Sandgrube/StepperMotorTestBench/Photos/PXL_20261024_214037839_cleaned.jpg

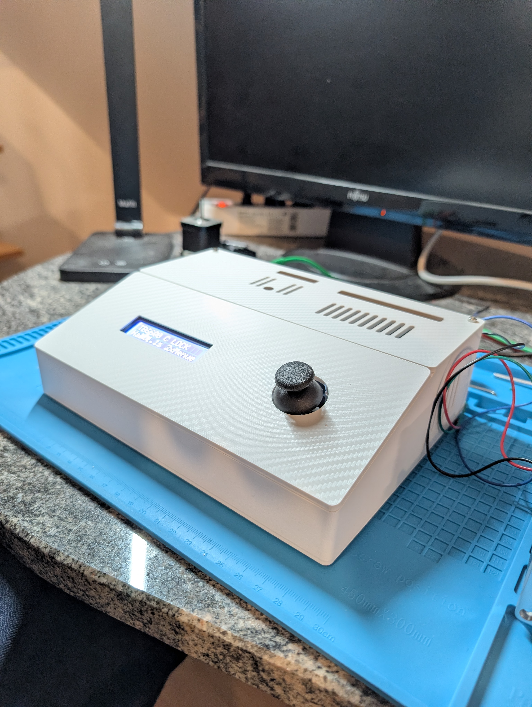
Photos/PXL_20261024_214037839_cleaned.jpg
