Sandgrube/StepperMotorTestBench/Photos/PXL_20261024_214016958_cleaned.jpg

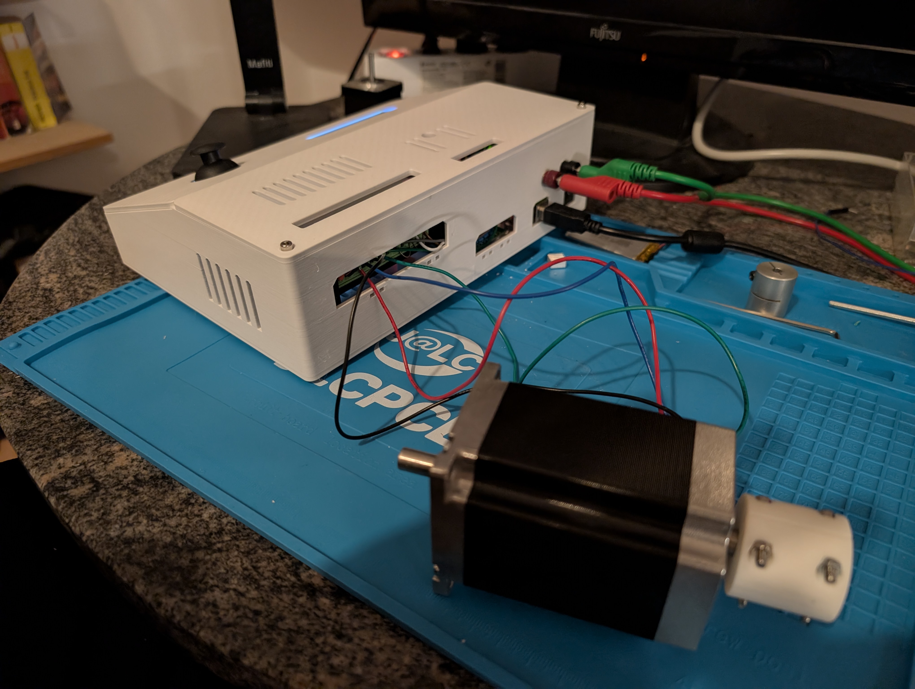
Photos/PXL_20261024_214016958_cleaned.jpg
