Sandgrube/StepperMotorTestBench/DOCUMENTATION/architecture.md

# Aufbau und Auswahl

Der Entwurf ist ein vollständig modellierter, passiv belüfteter Laboraufbau für die fünf vorgegebenen Module. Die Front trägt ausschließlich das vorhandene LCD und den Joystick. Alle Netzteile bleiben außerhalb. Drei Gehäuseteile: Bodenschale, fest verschraubte geneigte Front, separat abnehmbarer hinterer Deckel. Auf der Front sind keine Schraubenköpfe sichtbar; zwei Senkschrauben halten den Wartungsdeckel.

Verglichen wurden drei Verpackungsprinzipien. Nur Variante B wurde detailliert konstruiert und geometrisch geprüft. Die anderen Maße sind grobe Planungsabschätzungen, keine exportierten Alternativmodelle.

| Variante | Planungsmaß / Quader | Bewertung |
| --- | --- | --- |
| A: Treiber unter den Bedienelementen übereinander | ca. 180 × 176 × 85 mm / 2,69 l | Kleine Stellfläche; thermische Kopplung zum LCD; obere Module müssten zur Wartung heraus. |
| B: Drei Funktionszonen nebeneinander; gewählt | 230 × 176 × 64.24 mm / 2.60 l | Gemeinsamer offener Wartungsraum; eigene Wärmewege; kurze direkte Heckanschlüsse. |
| C: Alle Module hintereinander | ca. 150 × 230 × 72 mm / 2,48 l | Schmale, tiefe Stellfläche; mehr Leitungslänge und schlechtere seitliche Werkzeugzugänge. |

Die etwas größere Breite der gewählten Variante schafft reale Breite für Uno, 40-mm-Lochrasterplatine, TB6600 und deren Halter. Die vordere Zone enthält die Rückseiten von LCD und Joystick, vier Frontstützen sowie den Kabelbogen. Sie ist kein Platz für zusätzliche Elektronik.

Der TB6600 wird mit zwei verschiebbaren Bügeln und weichen Auflagepolstern gehalten. Originale Gehäuseschrauben und unbestätigte Modul-Bohrbilder werden nicht benutzt. Die Lochrasterplatine sitzt in Kantenhaltern und benötigt keine gebohrten Befestigungslöcher. Die Joystick-Montage verwendet vier 2-mm-Distanzringe; dünnere Ringe können einen kürzeren Knopf näher an die Außenseite bringen. Eine geänderte Bestückung ist erneut am Probestück zu prüfen.
