Sandgrube/StepperMotorTestBench/Photos/PXL_20261024_143449900_cleaned.jpg

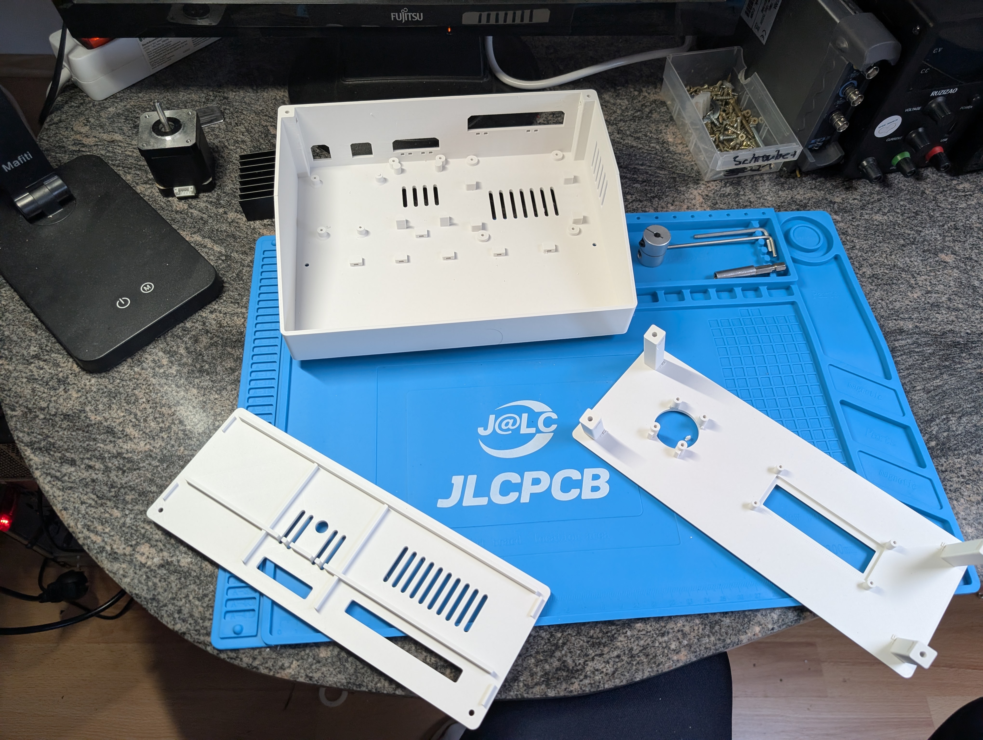
Photos/PXL_20261024_143449900_cleaned.jpg
