Sandgrube/StepperMotorTestBench/Photos/PXL_20261024_155425941 (1)_cleaned.jpg

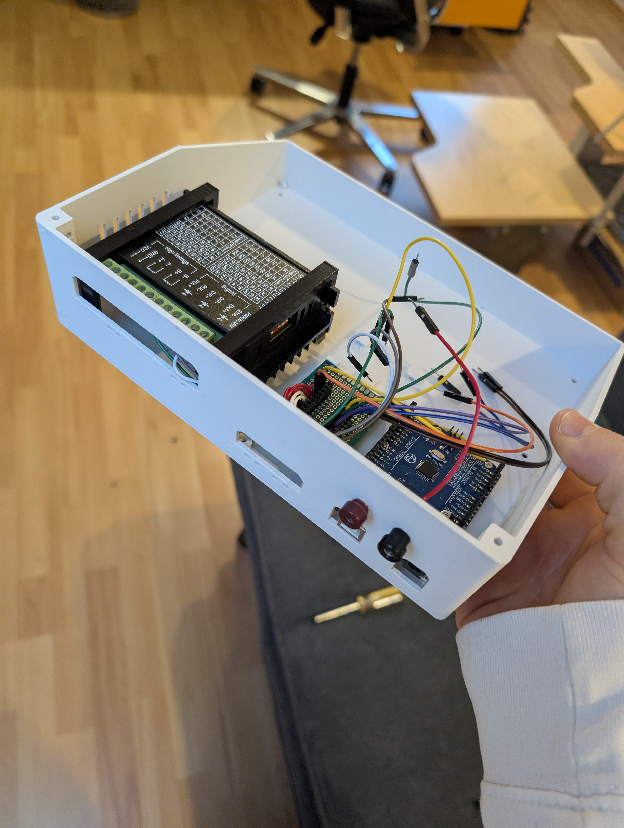
Photos/PXL_20261024_155425941 (1)_cleaned.jpg
