Sandgrube/StepperMotorTestBench/Photos/PXL_20261024_214004681_cleaned.jpg

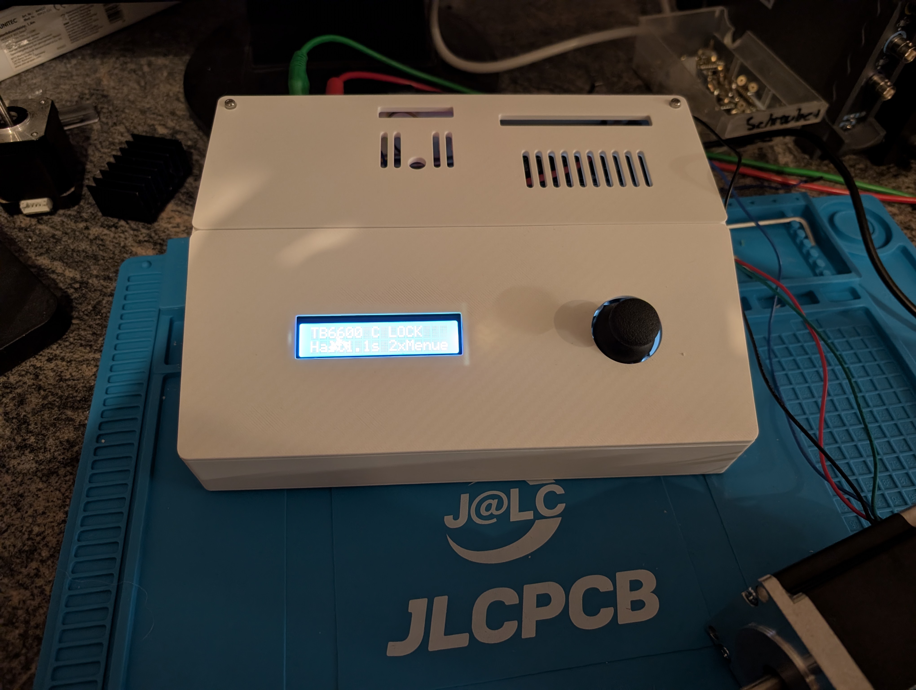
Photos/PXL_20261024_214004681_cleaned.jpg
