Sandgrube/StepperMotorTestBench/Photos/PXL_20261024_214041481_cleaned.jpg

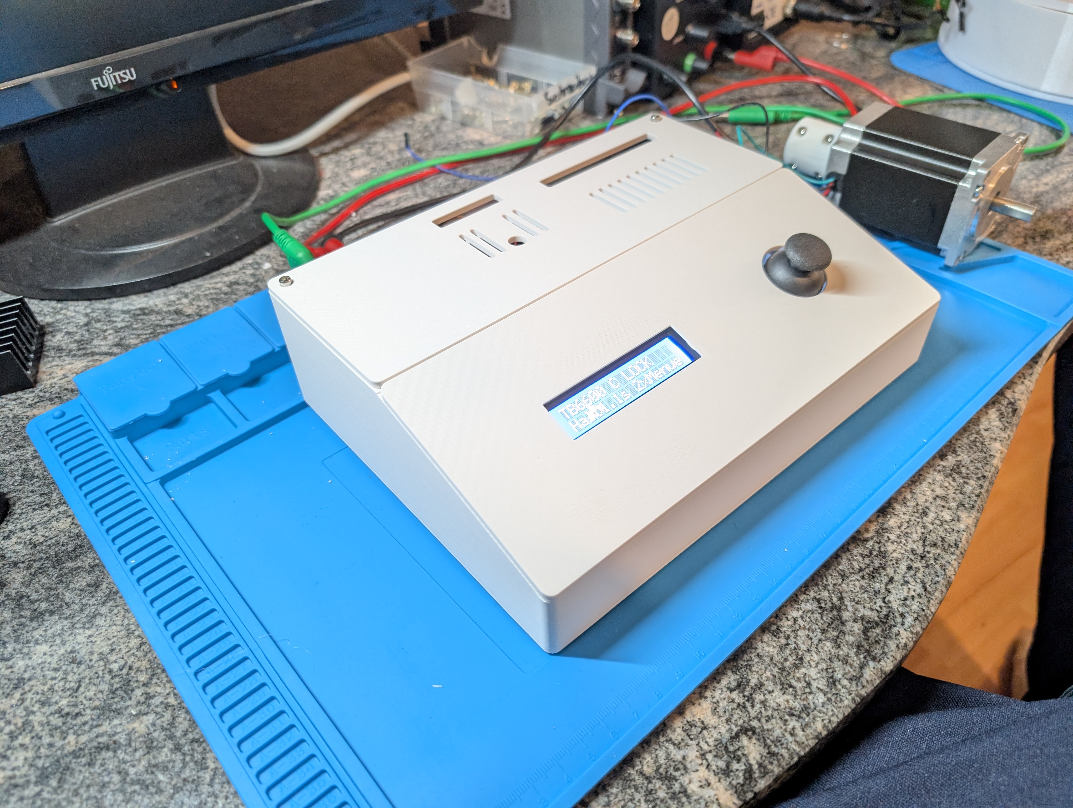
Photos/PXL_20261024_214041481_cleaned.jpg
