Sandgrube/StepperMotorTestBench/Photos/PXL_20261024_214044167_cleaned.jpg

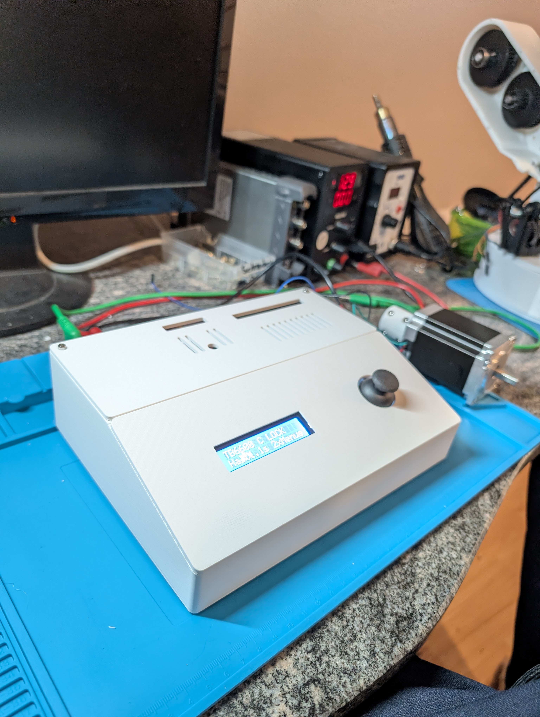
Photos/PXL_20261024_214044167_cleaned.jpg
