Sandgrube/StepperMotorTestBench/Photos/PXL_20261024_214047961_cleaned.jpg

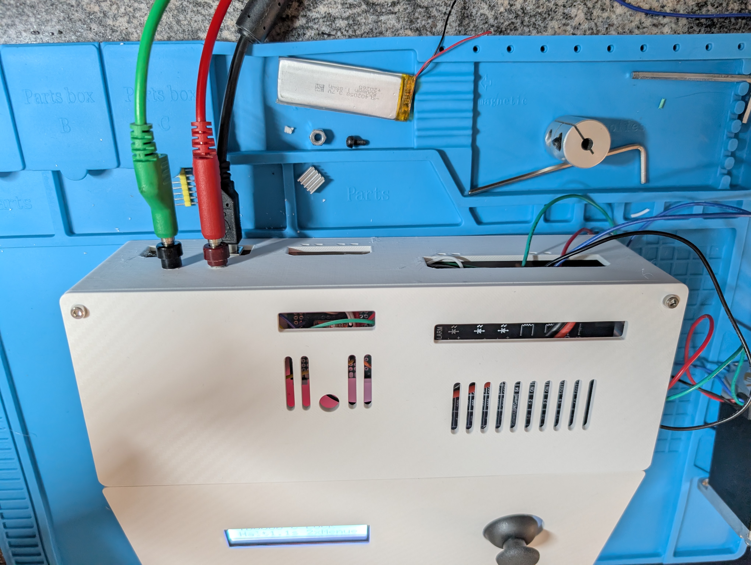
Photos/PXL_20261024_214047961_cleaned.jpg
