Sandgrube/StepperMotorTestBench/Photos/PXL_20261024_214056082_cleaned.jpg

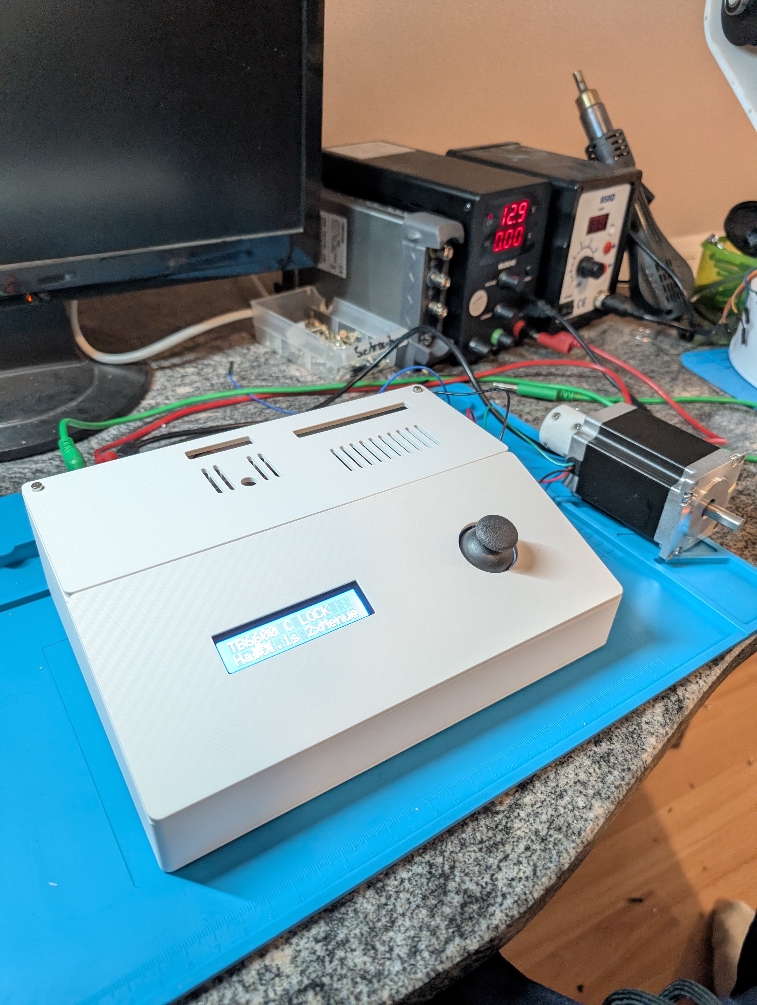
Photos/PXL_20261024_214056082_cleaned.jpg
