Sandgrube/StepperMotorTestBench/PREVIEWS/exploded.png

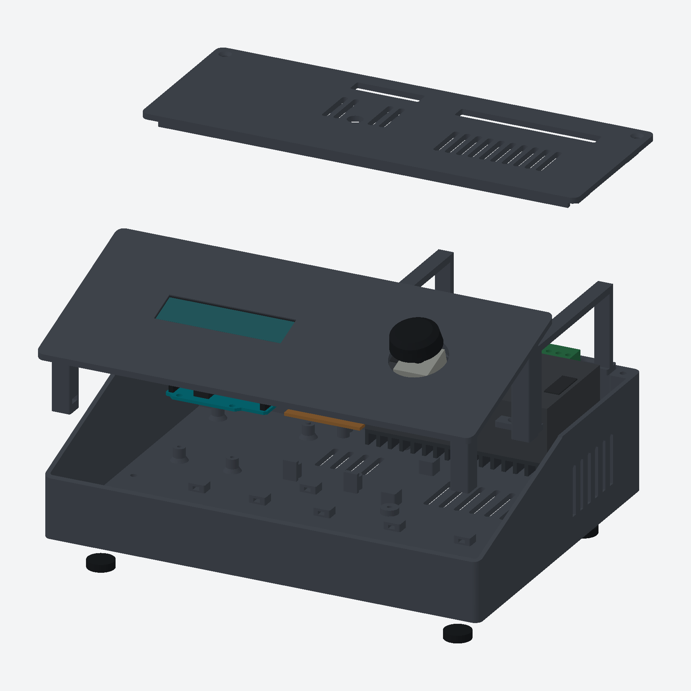
PREVIEWS/exploded.png
