Sandgrube/StepperMotorTestBench/PREVIEWS/front_ortho.png

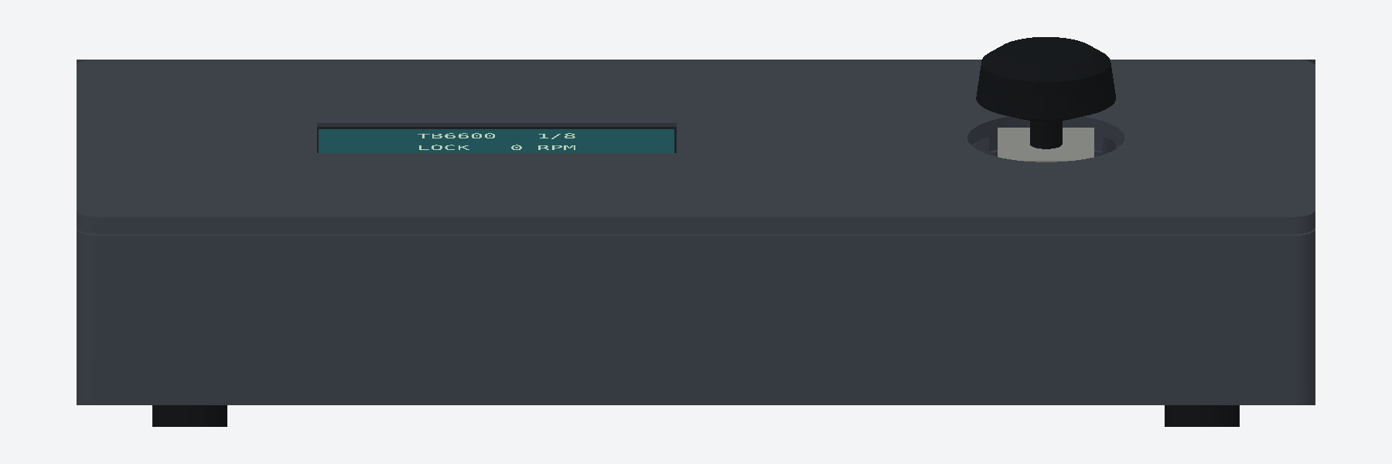
PREVIEWS/front_ortho.png
