Sandgrube/StepperMotorTestBench/PREVIEWS/front_rear_views.png

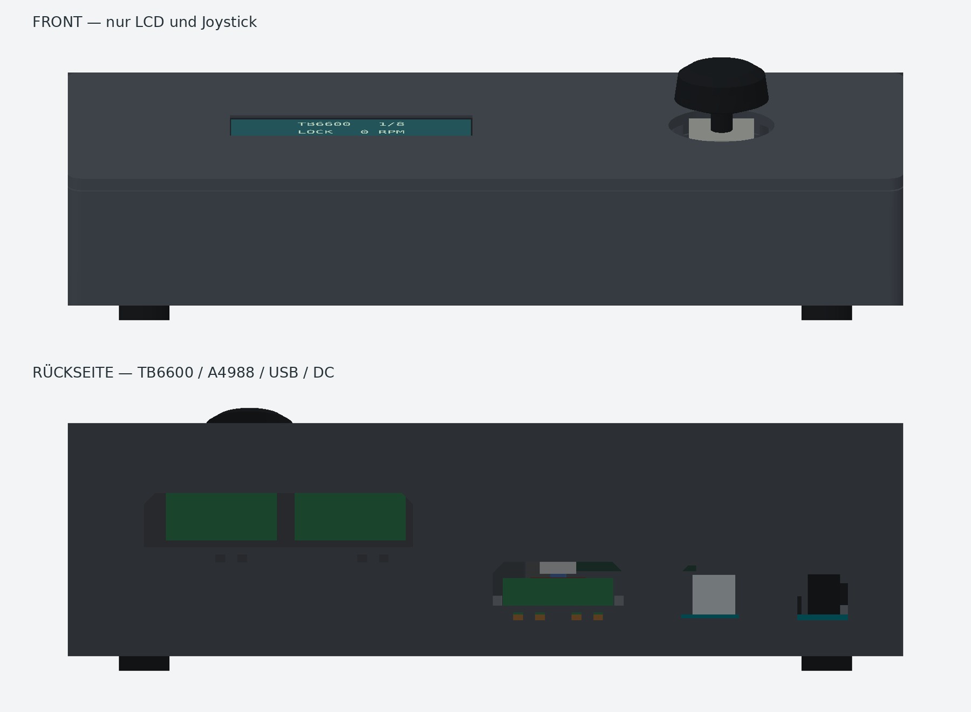
PREVIEWS/front_rear_views.png
