Sandgrube/StepperMotorTestBench/PREVIEWS/internal_layout.png

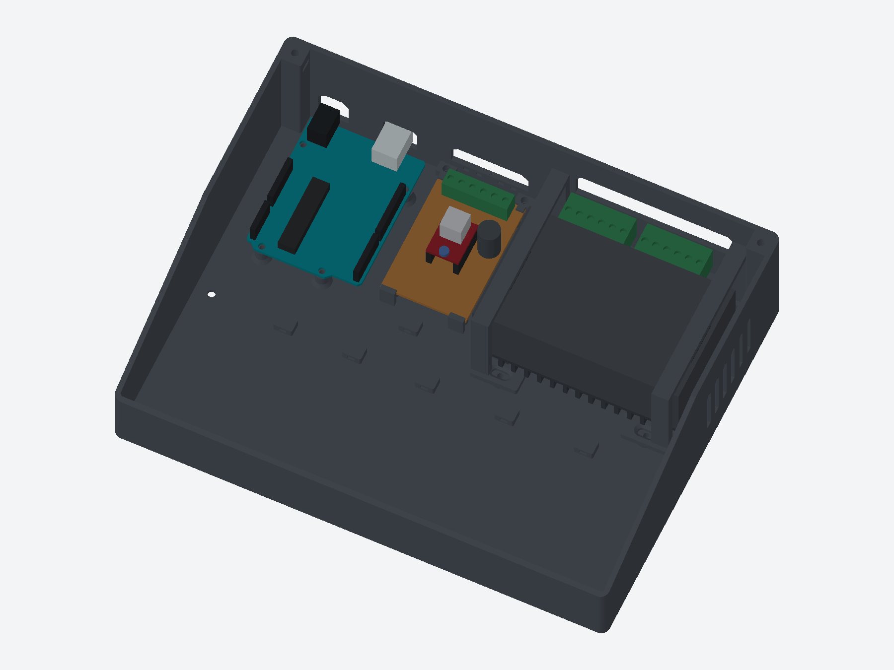
PREVIEWS/internal_layout.png
