Sandgrube/StepperMotorTestBench/PREVIEWS/rear.png

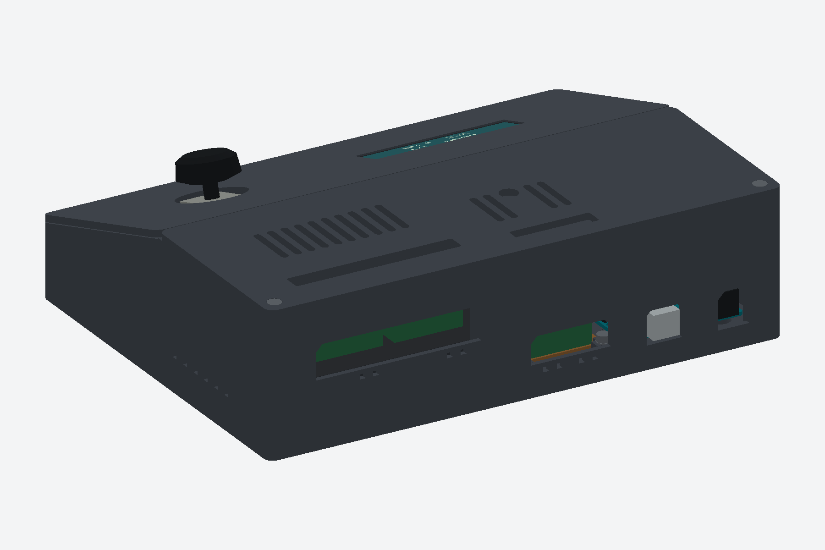
PREVIEWS/rear.png
