Sandgrube/StepperMotorTestBench/PREVIEWS/rear_ortho.png

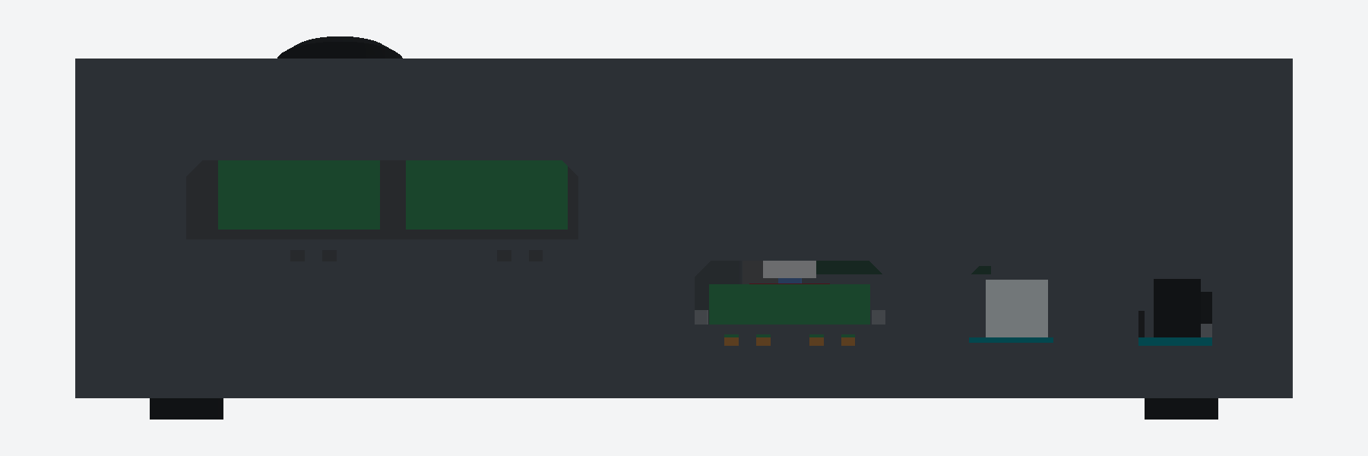
PREVIEWS/rear_ortho.png
