Sandgrube/StepperMotorTestBench/CAD/component_models/README.md

# Referenzkörper

Die STEP-Dateien enthalten selbst erzeugte vereinfachte B-reps in Einbaulage. Sie sind keine OEM-zertifizierten Produktmodelle. Lochkoordinaten und gesicherte Daten: siehe DOCUMENTATION/dimensions.md und sources.md. Die Datei uno_official_interface_extract.json enthält die Herkunft der Uno-XY-Schnittstellen. Keine fremden Polygonmodelle sind nötig, um die Baugruppe zu regenerieren.
