Sandgrube/StepperMotorTestBench/CAD/printed_parts_assembly.step

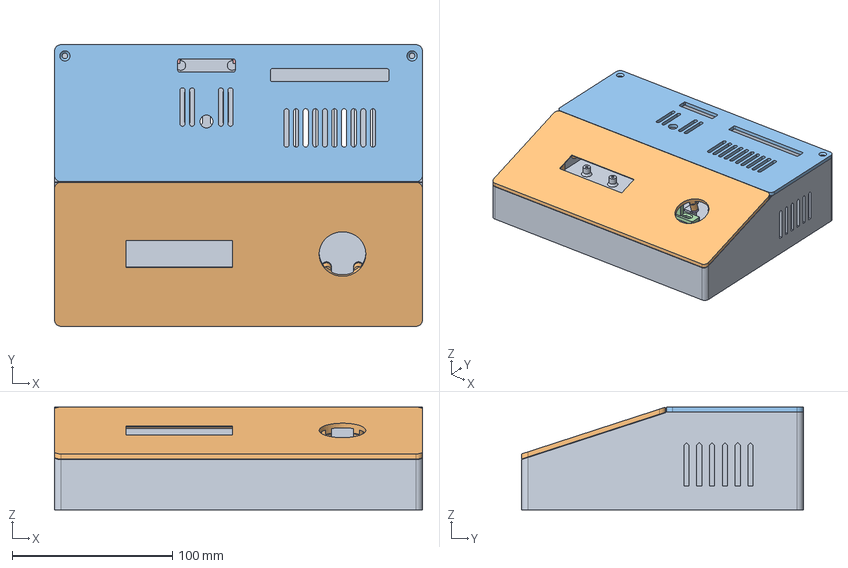
[picture p16: CAD file, 2026-10-23]
CAD/printed_parts_assembly.step
230.0 x 176.0 x 64.2 mm
