Sandgrube/StepperMotorTestBench/PRINT/assembly.3mf

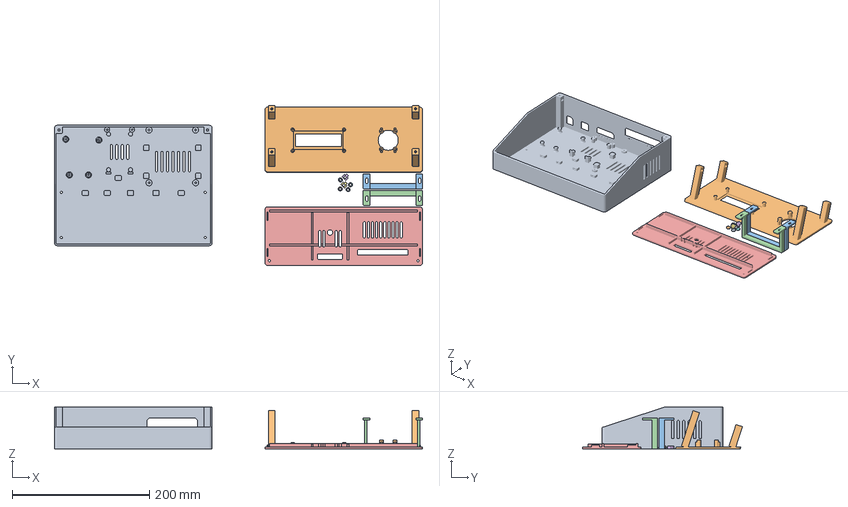
[picture p17: CAD file, 2026-10-24]
PRINT/assembly.3mf
537.2 x 233.5 x 61.2 mm
main_chassis.stl
front_panel.stl
tb_clamp_left.stl
tb_clamp_right.stl
top_cover.stl
a4988_edge_clip_1.stl
a4988_edge_clip_2.stl
joystick_spacer_1.stl
joystick_spacer_2.stl
joystick_spacer_3.stl
joystick_spacer_4.stl
