Sandgrube/StepperMotorTestBench/CAD/main_assembly.step

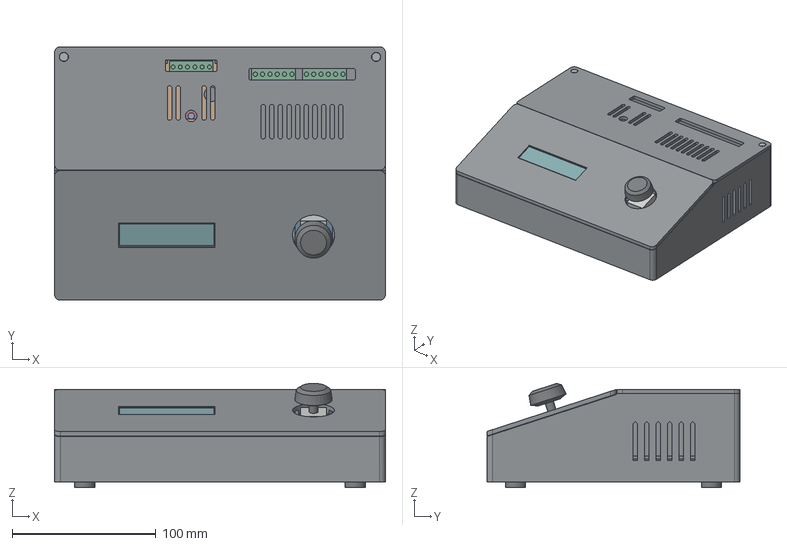
[picture p18: CAD file, 2026-10-23]
CAD/main_assembly.step
230.0 x 176.0 x 72.4 mm
main_chassis
front_panel
top_cover
tb_clamp_left
tb_clamp_right
a4988_edge_clip_1
a4988_edge_clip_2
joystick_spacer_1
joystick_spacer_2
joystick_spacer_3
joystick_spacer_4
UNO_PCB
UNO_USB
UNO_DC
UNO_header_0
UNO_header_1
UNO_header_2
UNO_header_3
UNO_DIP_envelope
LCD_PCB
LCD_bezel
LCD_glass
LCD_I2C_backpack_envelope
LCD_I2C_plug_keepout
JOYSTICK_PCB
JOYSTICK_gimbal_envelope
JOYSTICK_knob_and_stem
JOYSTICK_5pin_plug_keepout
TB6600_heatsink_reference
TB6600_housing_envelope
TB6600_terminal_0
TB6600_terminal_1
TB6600_compressed_foam_pad_0
TB6600_compressed_foam_pad_1
A4988_perfboard_40x60
A4988_socket_88.65
A4988_socket_101.35
A4988_driver_PCB
A4988_heatsink_envelope
A4988_pot_reference
A4988_VMOT_capacitor_envelope
A4988_6way_terminal_reference
adhesive_foot_0
adhesive_foot_1
adhesive_foot_2
adhesive_foot_3
M3x12_panel_0_head
M3x12_panel_0_shaft
M3_nut_panel_0
M3x12_panel_1_head
M3x12_panel_1_shaft
M3_nut_panel_1
M3x12_panel_2_head
M3x12_panel_2_shaft
M3_nut_panel_2
M3x12_panel_3_head
M3x12_panel_3_shaft
M3_nut_panel_3
M3x12_lid_0_head
M3x12_lid_0_shaft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
