Sandgrube/StepperMotorTestBench/PRINT/main_chassis.stl

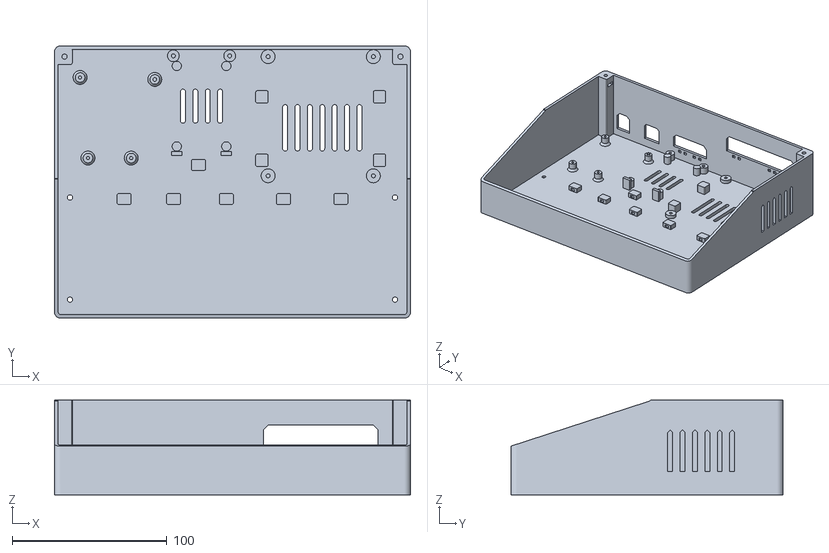
[picture p19: CAD file, 2026-10-23]
PRINT/main_chassis.stl
230.0 x 176.0 x 61.2
