Sandgrube/StepperMotorTestBench/CAD/component_models/uno_reference.step

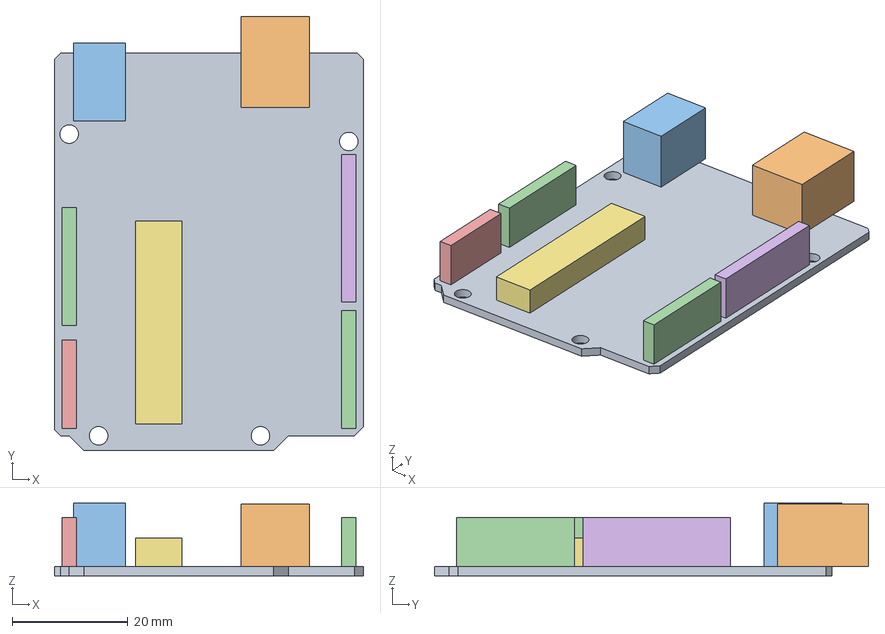
[picture p20: CAD file, 2026-10-23]
CAD/component_models/uno_reference.step
53.3 x 74.9 x 12.6 mm
