Sandgrube/StepperMotorTestBench/CAD/printed_parts/tb_clamp_left.step

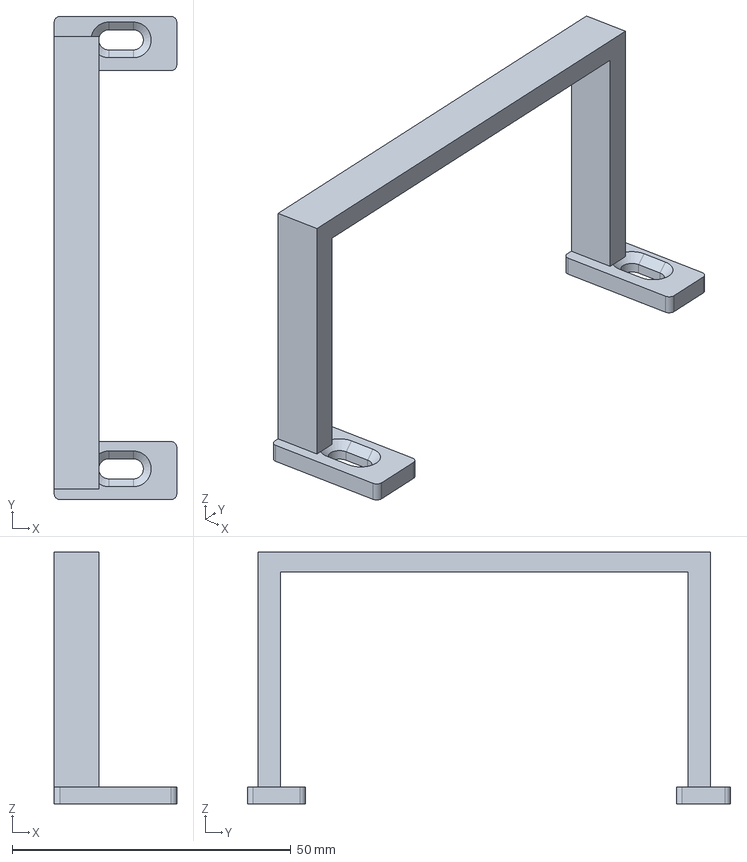
[picture p21: CAD file, 2026-10-23]
CAD/printed_parts/tb_clamp_left.step
22.0 x 86.7 x 45.2 mm
