Sandgrube/StepperMotorTestBench/PRINT/optional_parts/tpu_foot_print_4.stl

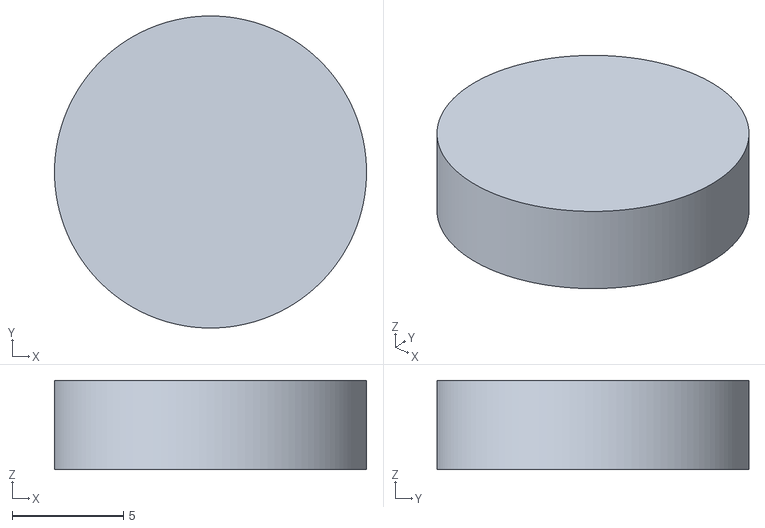
[picture p22: CAD file, 2026-10-23]
PRINT/optional_parts/tpu_foot_print_4.stl
14.0 x 14.0 x 4.00
