Sandgrube/StepperMotorTestBench/PRINT/tolerance_tests/m3_pilot_coupon.stl

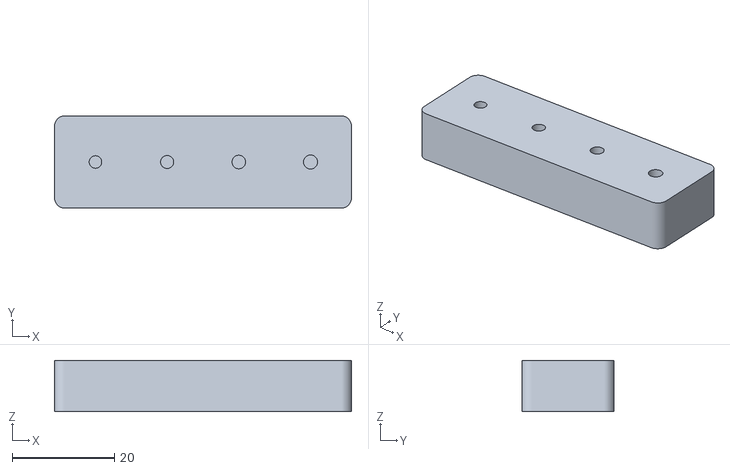
[picture p23: CAD file, 2026-10-23]
PRINT/tolerance_tests/m3_pilot_coupon.stl
58.0 x 18.0 x 10.0
