Sandgrube/StepperMotorTestBench/CAD/component_models/tb6600_reference.step

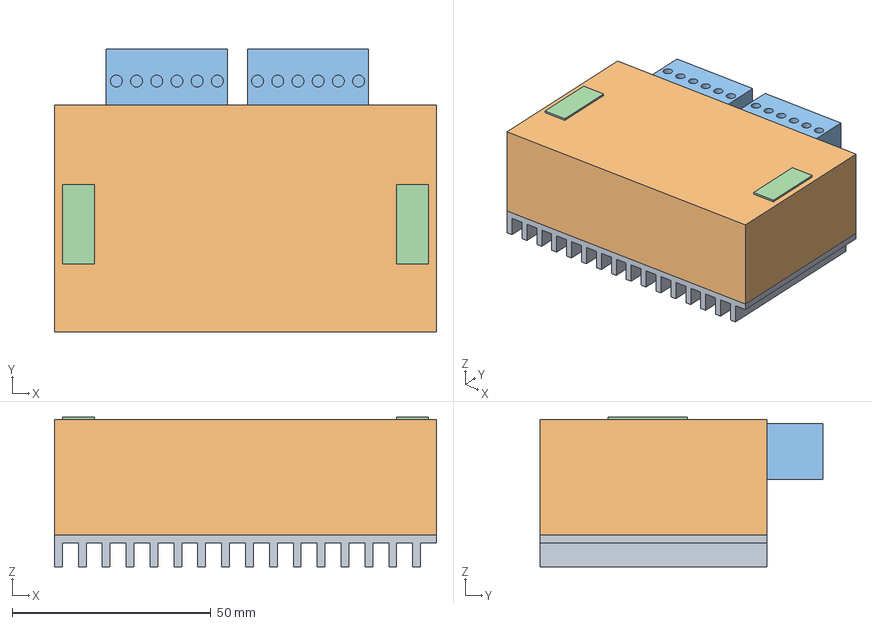
[picture p24: CAD file, 2026-10-23]
CAD/component_models/tb6600_reference.step
96.0 x 71.0 x 37.6 mm
