Sandgrube/StepperMotorTestBench/CAD/printed_parts/joystick_spacer_2.step

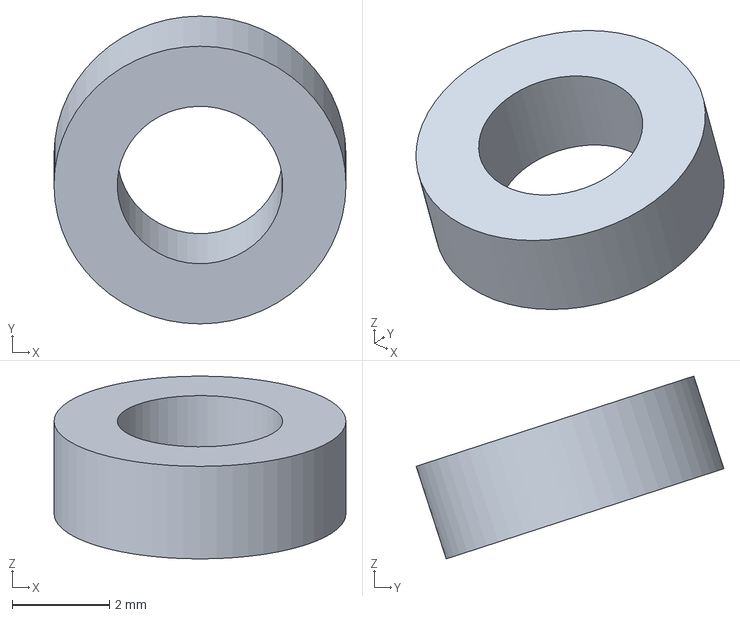
[picture p25: CAD file, 2026-10-23]
CAD/printed_parts/joystick_spacer_2.step
6.00 x 6.32 x 3.76 mm
