Sandgrube/StepperMotorTestBench/PRINT/tolerance_tests/joystick_pattern_coupon.stl

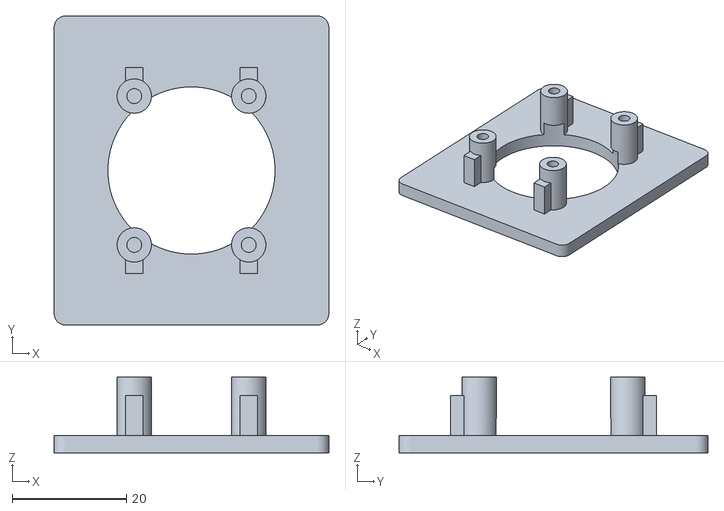
[picture p26: CAD file, 2026-10-23]
PRINT/tolerance_tests/joystick_pattern_coupon.stl
48.0 x 54.0 x 13.2
