Sandgrube/StepperMotorTestBench/CAD/component_models/joystick_reference.step

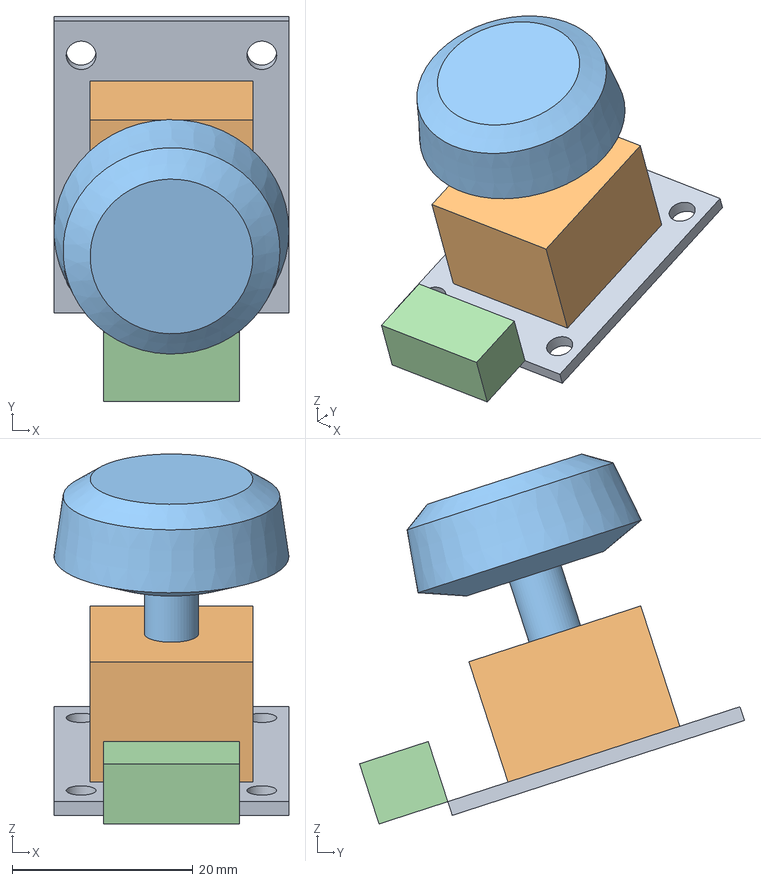
[picture p27: CAD file, 2026-10-23]
CAD/component_models/joystick_reference.step
26.0 x 42.6 x 40.9 mm
