Sandgrube/StepperMotorTestBench/PRINT/joystick_spacer_4.stl

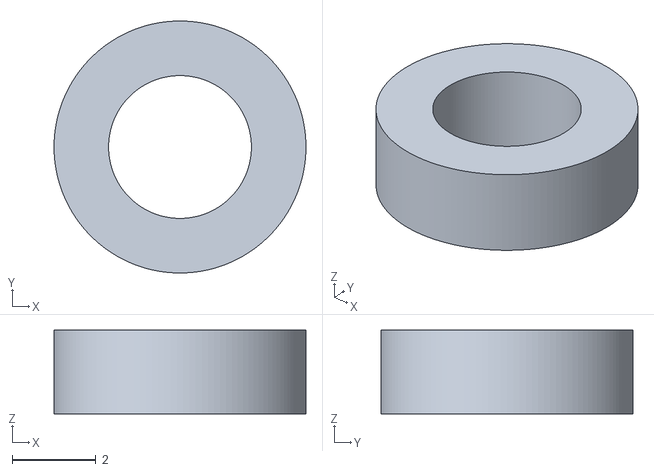
[picture p28: CAD file, 2026-10-23]
PRINT/joystick_spacer_4.stl
6.00 x 6.00 x 2.00
