Sandgrube/StepperMotorTestBench/CAD/component_models/lcd_reference.step

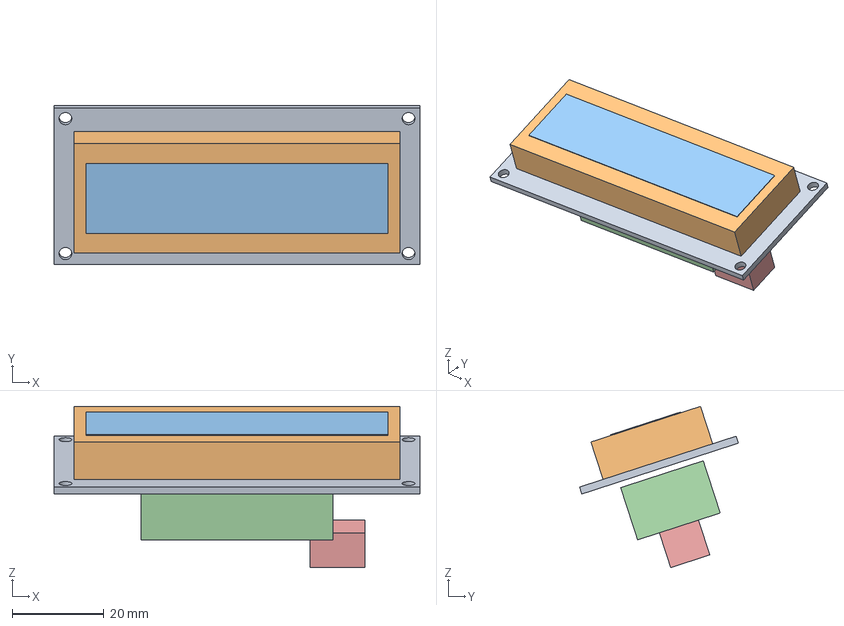
[picture p29: CAD file, 2026-10-23]
CAD/component_models/lcd_reference.step
80.0 x 34.7 x 35.2 mm
