Sandgrube/StepperMotorTestBench/CAD/printed_parts/lcd_fit_coupon.step

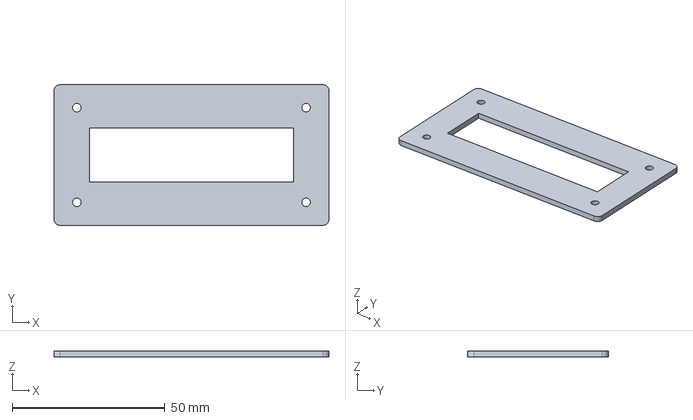
[picture p30: CAD file, 2026-10-23]
CAD/printed_parts/lcd_fit_coupon.step
90.0 x 46.0 x 2.00 mm
