Sandgrube/StepperMotorTestBench/PRINT/a4988_edge_clip_2.stl

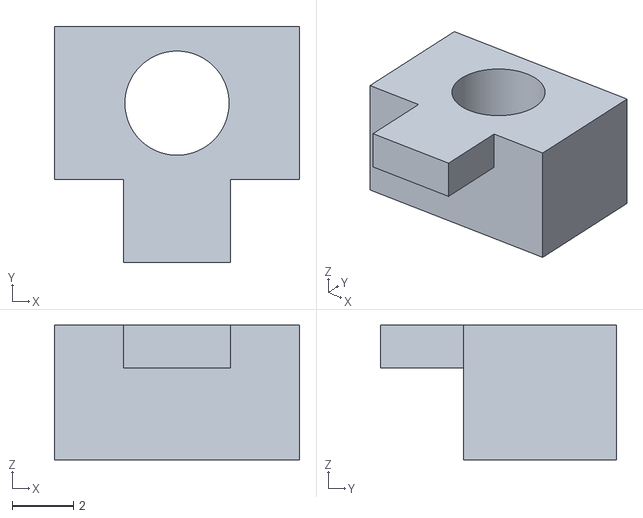
[picture p31: CAD file, 2026-10-23]
PRINT/a4988_edge_clip_2.stl
8.00 x 7.70 x 4.40
