Sandgrube/StepperMotorTestBench/PRINT/tolerance_tests/rear_ports_coupon.stl

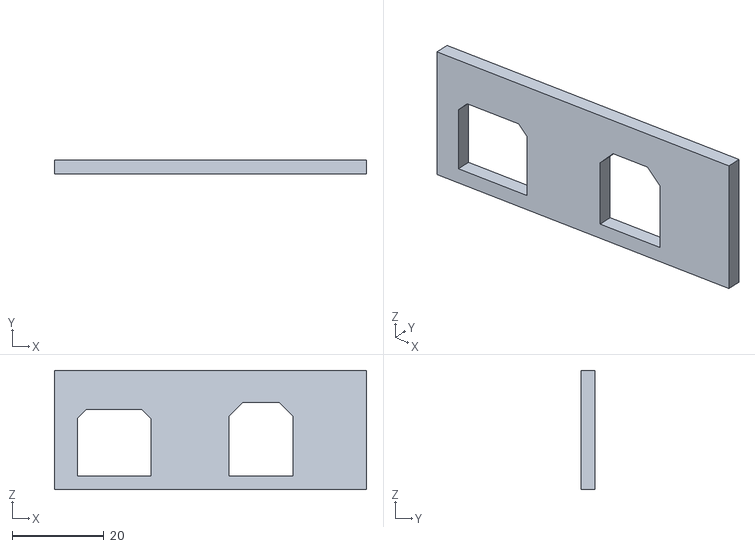
[picture p32: CAD file, 2026-10-23]
PRINT/tolerance_tests/rear_ports_coupon.stl
68.0 x 3.00 x 26.0
