Sandgrube/StepperMotorTestBench/CAD/component_models/a4988_reference.step

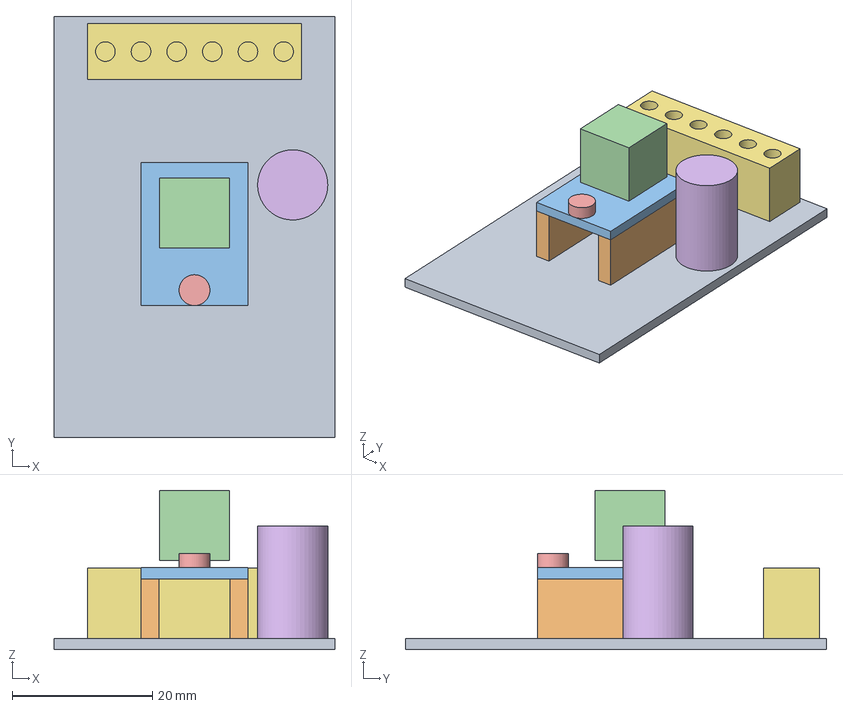
[picture p33: CAD file, 2026-10-23]
CAD/component_models/a4988_reference.step
40.0 x 60.0 x 22.7 mm
