Sandgrube/StepperMotorTestBench/CAD/component_models/feet_reference.step

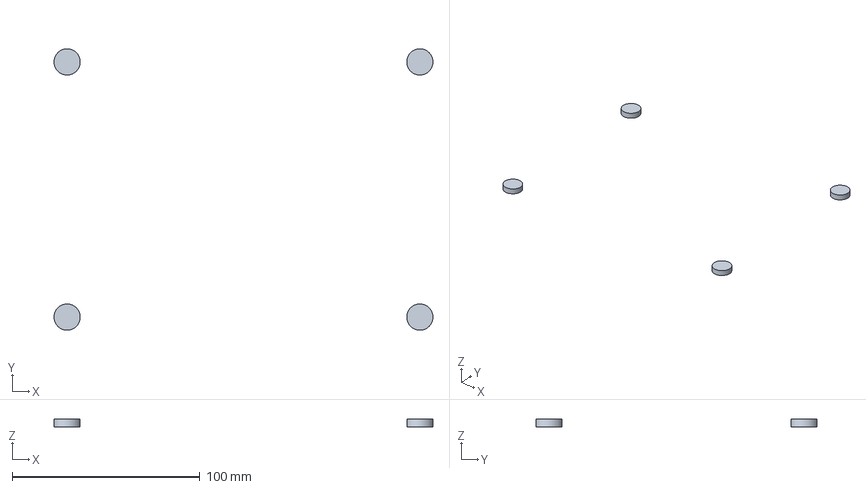
[picture p34: CAD file, 2026-10-23]
CAD/component_models/feet_reference.step
202.0 x 150.0 x 4.00 mm
