Sandgrube/StepperMotorTestBench/PRINT/top_cover.stl

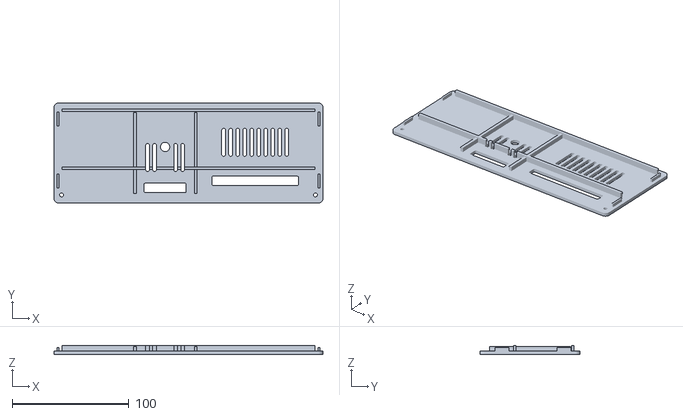
[picture p35: CAD file, 2026-10-23]
PRINT/top_cover.stl
230.0 x 85.7 x 8.00
