Sandgrube/StepperMotorTestBench/CAD/printed_parts/front_panel.step

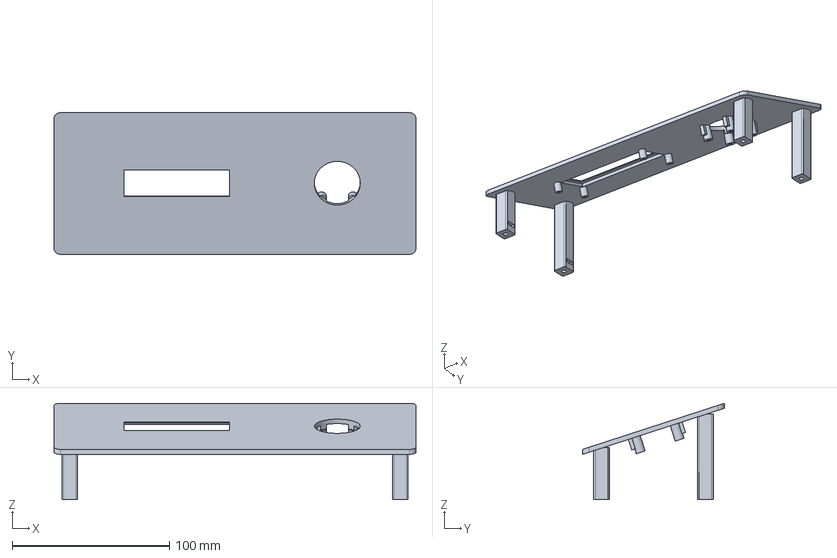
[picture p36: CAD file, 2026-10-23]
CAD/printed_parts/front_panel.step
230.0 x 90.0 x 61.2 mm
