Sandgrube/StepperMotorTestBench/PRINT/front_panel.stl

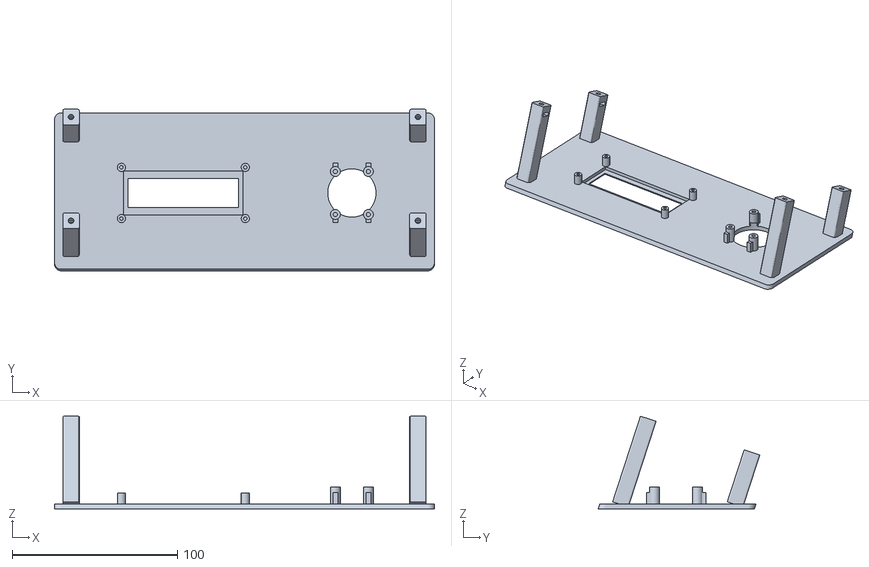
[picture p37: CAD file, 2026-10-23]
PRINT/front_panel.stl
230.0 x 97.9 x 56.1
