Sandgrube/StepperMotorTestBench/(list of files, cad)

Other CAD files:
CAD/printed_parts/main_chassis.step
PRINT/tb_clamp_left.stl
CAD/printed_parts/m3_pilot_coupon.step
CAD/printed_parts/tb_clamp_right.step
PRINT/joystick_spacer_2.stl
PRINT/tolerance_tests/lcd_fit_coupon.stl
CAD/printed_parts/joystick_spacer_1.step
CAD/printed_parts/a4988_edge_clip_1.step
CAD/printed_parts/joystick_spacer_4.step
PRINT/tb_clamp_right.stl
CAD/printed_parts/a4988_edge_clip_2.step
PRINT/joystick_spacer_1.stl
CAD/printed_parts/joystick_spacer_3.step
CAD/printed_parts/joystick_pattern_coupon.step
CAD/printed_parts/rear_ports_coupon.step
CAD/printed_parts/top_cover.step
CAD/printed_parts/m3_nut_coupon.step
PRINT/tolerance_tests/m3_nut_coupon.stl
