Sandgrube/StepperMotorTestBench/Software/Stepper_Testbench_Software_LGT8F328/DOCUMENTATION/software_guide.html

STEPPER
TESTBENCHDrucken / als PDF speichern

Firmware & Inbetriebnahme

# Der Teststand. Die Software.

LGT8F328 · TB6600 · A4988 · XY-Joystick · 16×2-LCD

Version 2.1.024.10.2026Pinbelegung Gehäuse R1AVR-Build geprüft

## 1. LGT8F328 einrichten

Diese Ausgabe 2.1 ist für LGT8F328P und LGT8F328D mit 16 oder 32 MHz angepasst. Die alte Auswahl „Arduino Uno“ ist hier gesperrt. Treiber, LCD, Joystick und Bedienung bleiben gleich.

Die genaue Variante ist noch unbekannt. „LGT8F328“ allein legt weder P/D noch Bauform oder Versorgungsspannung fest. Die Profile sind geprüfte Buildziele; keines wurde als dein konkretes Board identifiziert. Nicht allein wegen eines passenden Namens eine beliebige HEX-Datei hochladen.

1. In der Arduino IDE unter Datei → Voreinstellungen die zusätzliche Boardverwalter-URL eintragen:

https://raw.githubusercontent.com/dbuezas/lgt8fx/master/package_lgt8fx_index.json
2. In der Boardverwaltung lgt8fx 2.0.7 installieren. Falls die Toolchain fehlt, zusätzlich Arduino AVR Boards installieren; als Ziel trotzdem LGT8F328 wählen.
3. Bibliothek hd44780 1.3.2 von Bill Perry installieren. Die unveränderte Bibliotheks-ZIP liegt auch in third_party. Nicht LiquidCrystal_I2C verwenden.
4. ZIP entpacken und Stepper_Testbench_LGT8F328/Stepper_Testbench_LGT8F328.ino öffnen. Die Begleitdateien im Sketchordner belassen. Alternativ die Ein-Datei-Ausgabe unter single_file öffnen.
5. Werkzeuge → Board → LGT8fx Boards → LGT8F328. Unter Variant die tatsächliche P/D- und Gehäuseausführung wählen. Für den anfänglichen 16-MHz-Betrieb: Clock Source = Internal 32MHz, Clock Divider = 2. Divider 1 entspricht 32 MHz. Nur diese beiden CPU-Takte sind freigegeben.
6. Den realen seriellen Port wählen. Upload speed zunächst nach vorhandenem Bootloader wählen; die bereitgestellten CLI-Profile verwenden 57600. Bei Verbindungsfehler kann ein anderer Bootloader 115200 verlangen. Es wird kein neuer Bootloader gebrannt.
7. Für den ersten Upload beide Motorversorgungen ausschalten; nur die passende Board-/USB-Logikversorgung betreiben. Joystick beim Start zentriert lassen. Serieller Monitor: 115200 Baud, unabhängig von der Uploadgeschwindigkeit.
8. Stromlos verdrahten, Stromlimits und echte Microstep-DIP-Einstellung prüfen. Ersttest 5 RPM / 15° ohne mechanische Last.

Profil | Chip / Gehäuse | CPU-Takt | IDE-Variant / Divider
p16 | LGT8F328P · LQFP32 | 16 MHz | 328P-LQFP32 / 2
p32 | LGT8F328P · LQFP32 | 32 MHz | 328P-LQFP32 / 1
d16 / d32 | LGT8F328D · LQFP32 | 16 / 32 MHz | 328D / 2 bzw. 1
p48_16 / p48_32 | LGT8F328P · LQFP48 | 16 / 32 MHz | 328P-LQFP48 / 2 bzw. 1

Bei LQFP32 liegen acht Beinchen an jeder der vier Chipseiten, bei LQFP48 zwölf. P oder D muss vom Chipaufdruck bzw. einer verlässlichen Boardangabe kommen. Die zweireihige SSOP20-Variante wird wegen der anderen Pinbelegung von dieser Verdrahtung ausdrücklich abgewiesen.

Versorgung: Der bisherige Anschlussplan setzt ein Board mit passender 5-V-Logik voraus. Eine vorhandene 3,3-V-Variante ist damit nicht automatisch elektrisch kompatibel zu LCD-Backpack und TB-Eingängen. Boardspannung vorher prüfen. Die Firmware hebt keine Spannung an.

Gehäuse: Die bisherige CAD-Halterung entspricht dem Uno-R3-Format. Ein LGT-Chip kann auf Uno-, Nano- oder anderen Platinen sitzen. Nur bei tatsächlich passender Platinenkontur, Bohrungslage und USB-Position gilt diese Halterung weiter. Aus dem Chipnamen wird keine neue mechanische Passung abgeleitet.

## 2. Bedienung

Situation | Eingabe | Verhalten
Einschalten | Stick zentriert lassen | Kalibrierung; anschließend LOCK. Es startet keine Fahrt.
Freigeben | Zentriert 1,1 s drücken; dann loslassen | ARM. Der Stick muss während der gesamten Haltezeit zentriert bleiben.
Richtung / Tempo | X links/rechts und Y auf/ab | X wählt die Richtung. Der Betrag der Y-Auslenkung bestimmt die Geschwindigkeit.
Dauerlauf beenden | X oder Y in die Mitte | Der Sollwert fährt über die Bremsrampe auf null.
Fahrt starten | Im Modus Fahrt beide Achsen auslenken | Eine Fahrt wird mit dem dabei gewählten Tempo gestartet; danach läuft sie unabhängig vom Stick zu Ende.
Weitere Fahrt | X nach Fahrtende zentrieren, dann erneut auslenken | Keine vorab gespeicherte Wiederholung. Zentrieren während einer laufenden Fahrt bricht sie nicht ab.
Stoppen / Sperren | Einmal kurz drücken | Neue STEP-Flanken werden gestoppt; ein bereits laufender Impuls endet. LOCK.
Menü öffnen | Zweimal kurz drücken | Abstand der entprellten Druckereignisse unter 350 ms. Die erste Betätigung stoppt bereits.
Menü bedienen | Y: Seite; X: Wert | Längeres Halten wiederholt. Bei diagonaler Eingabe wird nur die Seite gewechselt.
Speichern / verlassen | Im Menü einmal drücken | EEPROM speichern, Ausgänge konfigurieren, zurück zu LOCK.

Der Knopf ist ein Software-Stopp mit 25-ms-Entprellung und zusätzlicher Laufzeit des Hauptablaufs; eine reale Reaktionszeit wurde nicht gemessen. Ein kurzer Stopp bremst nicht über die normale Rampe; die Mechanik kann nachlaufen oder Schritte verlieren. Nach jedem Stopp, Menübesuch und Neustart muss erneut freigegeben werden. Während der Freigabetaster noch gehalten wird, beginnen keine Pulse.

Beispielanzeige · C = Dauerlauf, J = Fahrt

TB6600 C LOCK

Halt1.1s 2xMenue

ARM bedeutet freigegeben, RUN bedeutet laufender Pulsbefehl. RPM ist aus der ausgegebenen Pulsrate berechnet; es gibt keine gemessene Motordrehzahl. Bei einer Fahrt zeigt die zweite Zeile die verbleibenden STEP-Impulse.

## 3. Profile und Einstellungen

Nr. | Anzeige | Werte | Bedeutung
1 | Treiber | TB6600 / A4988 | Wählt den STEP-Ausgang. Keine elektrische Umschaltung des Motors.
2 | Modus | Dauerlauf / Fahrt | Dauerlauf folgt dem Stick; Fahrt führt einen vorgegebenen Winkel aus.
3 | Vollschr | 48 / 100 / 200 / 400 | Physikalische Vollschritte pro Motorumdrehung, ohne Microstep-Faktor.
4 | Mikro | TB: 1…32; A: 1…16 | TB: 1, 2, 4, 8, 16, 32. A: 1, 2, 4, 8, 16. TB-DIP manuell angleichen.
5 | Max RPM | 3 / 5 / 10 / 15 / 20 / 30 / 45 / 60 / 90 / 120 / 180 / 240 | Obergrenze; zusätzlich gelten maximal 4000 STEP-Impulse/s.
6 | Beschl | 10 / 20 / 40 / 60 / 90 / 120 / 180 / 240 / 360 rpm/s | Beschleunigungs- und Bremsrampe im normalen Fahrbetrieb.
7 | Weg Grad | 15 / 30 / 45 / 90 / 180 / 360 / 720 / 1440 | Winkel an der Motorwelle, ohne automatische Getriebeumrechnung.
8 | Halten | Ein / Aus | A4988: Leerlauf-Haltestrom solange ARM. TB nur mit geprüfter optionaler ENA-Leitung.
9 | Richtung | Normal / Invertiert | Elektrische DIR-Polarität je Treiberprofil umkehren.

Die beiden Treiber besitzen unabhängige Profile. Neue Standardwerte: 200 Vollschritte/U, 1/8 Microstepping, 15 RPM, 60 RPM/s, 180°, Dauerlauf, Halten aus, Richtung normal. Gültige vorhandene v1/v2-Daten werden erkannt. Beim LGT ist EEPROM jedoch Flash-emuliert; ein Firmwareupload kann diese Daten löschen. Nach jedem Upload die Profile kontrollieren.

Speichern erfolgt beim Verlassen des Menüs. CRC und Bereichsprüfungen verwerfen unvollständige oder ungültige EEPROM-Daten; dann gelten die Standardwerte. Die Firmware speichert nicht laufend während der Bewegung. Die LGT-E2PROM-Bibliothek wird mit 1 KB logischer Kapazität verwendet; der Flashbedarf ist in der Boardgrenze berücksichtigt. Jeder Speichervorgang wird zurückgelesen und mit CRC geprüft. Bei Fehler bleibt LOCK. Für den D-Chip kennzeichnet der Core seine EEPROM-Unterstützung selbst als ungetestet; der erfolgreiche Build ersetzt diese Hardwareprüfung nicht.

## 4. Vollständiger Anschlussplan

Board / Versorgung | Ziel | Funktion
A0 | Joystick VRx | X: Richtung
A1 | Joystick VRy | Y: Geschwindigkeit in beiden Auslenkrichtungen
D2 | Joystick SW | Gegen GND schaltend; interner Pull-up
D3 | TB6600 PUL+ | STEP; PUL− an Board-GND
D4 | TB6600 DIR+ | DIR; DIR− an Board-GND
D5 | TB6600 ENA+ optional | Standard: ENA+ und ENA− beide offen lassen
D6 | A4988 STEP | Schrittimpulse
D7 | A4988 DIR | Drehrichtung
D8 | A4988 ENABLE | Aktiv LOW
D9 / D10 / D11 | A4988 MS1 / MS2 / MS3 | Microstepping durch die Firmware
A4 / A5 | LCD SDA / SCL | 100-kHz-I²C; Backpack automatisch erkannt
5V | LCD VCC, Joystick VCC, A4988 VDD | Nur Logikversorgung
GND | LCD, Joystick, A4988 Logik-GND | Gemeinsame Logikmasse; TB-Signalminus wie oben
VDD lokal | A4988 RESET und SLEEP | Beide auf HIGH / 5V; nicht offen lassen
Separate DC-Versorgung | A4988 VMOT und Motor-GND | Motor-GND mit Logik-GND nach Carrier-Schaltbild verbinden
Separate DC-Versorgung | TB6600 VCC und Leistungs-GND | Spannung nach Aufdruck des konkreten Moduls

Die TB-Signale sind als Common Cathode vorgesehen: PUL− und DIR− an Board-GND, PUL+ und DIR+ direkt an D3 und D4. Das reale Modul muss für 5-V-Ansteuerung und den verfügbaren Pin-Ausgangsstrom geeignet sein. Modulbezeichnung allein beweist das nicht.

A4988-Motorwicklungen: eine Wicklung an 1A/1B, die andere an 2A/2B. TB6600: entsprechend A+/A− und B+/B−. Wicklungspaare vorab am stromlosen Motor identifizieren. Die Leistungsanschlüsse beider Treiber niemals gleichzeitig an denselben Motor legen. Für einen gemeinsamen Testmotor beide Treiberversorgungen ausschalten, dann manuell umstecken.

Keine Motorversorgung an den Board-5V-Pin anschließen. TB6600- und A4988-Spannung werden nicht automatisch angepasst; ihre zulässigen Spannungen können verschieden sein. USB versorgt hier die Logik. Ein externer Board-Versorgungseingang darf nur nach dem tatsächlichen Platinenaufbau verwendet werden; ein Nano-artiges LGT-Board besitzt nicht automatisch die Uno-DC-Buchse.

## 5. Leistungsteil und Strombegrenzung

Am A4988 einen 100-µF-Elektrolytkondensator unmittelbar zwischen VMOT und Motor-GND montieren, richtige Polarität und passende Spannungsfestigkeit beachten. Für den im Gehäuse vorgesehenen 12/24-V-Aufbau ist ein geeigneter 50-V-Typ vorgesehen. Der Pololu-Referenzcarrier nennt 8–35 V Motorversorgung; das ist keine Freigabe für einen unbekannten Klon oder Spannungsspitzen.

Das A4988-Stromlimit wird am vorhandenen Potentiometer eingestellt. Die Beziehung des ICs lautet Imax = Vref / (8 · Rsense). Erst die tatsächlich bestückten Messwiderstände und Carrier-Schaltung prüfen; keinen pauschalen Vref-Faktor für alle roten Platinen verwenden. TB6600-Stromlimit und Schrittauflösung werden an dessen DIP-Schaltern eingestellt.

Motorkabel und Treibermodule nur bei ausgeschalteter Versorgung umstecken. Lüftung und Kühlkörper freihalten. Die Firmware misst weder Temperatur noch Motorstrom und hat keine thermische Abschaltfunktion. Beim ersten Dauerlauf die Temperatur extern kontrollieren und das Stromlimit entsprechend anpassen.

Reset und Bootloader laufen vor der Firmware. Soll auch in dieser Zeit ein definierter A4988-Logikzustand bestehen, sind ein 10-kΩ-Pull-up von ENABLE zu VDD und ein 10-kΩ-Pull-down von STEP zu GND auf dem Träger sinnvoll. Software allein legt die Pins während Reset nicht fest.

## 6. TB6600: Microstepping und optionales ENA

Standard: beide ENA-Klemmen offen. Dann stoppt die Firmware die TB-Pulse, kann aber dessen Haltestrom nicht abschalten. Das gilt auch bei LOCK und wenn A4988 ausgewählt ist. Das Menü zeigt deshalb „TB ENA offen“.

Der TB-Menüwert für Microstepping ist eine Rechengröße. Er verstellt keine DIP-Schalter. Der eingestellte DIP-Teiler muss dazu passen; eine universelle DIP-ON/OFF-Tabelle wäre bei den unterschiedlichen Modulen unzuverlässig.

Optional: Nur bei überprüftem Modul ENA− an Board-GND und ENA+ an D5 anschließen. In Config.h TB_ENABLE_WIRED 1 setzen und TB_DISABLE_LEVEL auf den gemessenen Offline-Pegel einstellen: 1 für HIGH = offline, 0 für LOW = offline. Vor dem ersten Fahrversuch ohne Last verifizieren. Die zusätzliche Variante wurde kompiliert; ihre elektrische Polarität wurde nicht an deinem Modul gemessen.

## 7. Pulsrate, Rampen und Positionsgrenzen

Timer1 verwendet ausdrücklich den CPU-Takt, nicht den LGT-Hochgeschwindigkeitstakt. OCR1A wird aus F_CPU berechnet: 199 bei 16 MHz und 399 bei 32 MHz, jeweils mit Prescaler 8. Damit ist der nominale Takt in beiden Profilen 10 kHz. Die Genauigkeit folgt dem realen Oszillator und wurde nicht gemessen. Maximal sind 4000 STEP-Impulse/s vorgesehen. Der Scheduler plant nominal 100 µs HIGH und mindestens 100 µs LOW; die reale Flankenzeit und der Interrupt-Jitter wurden nicht am Oszilloskop gemessen. Timer1 darf nicht gleichzeitig von Servo- oder anderen Timer1-Bibliotheken benutzt werden. D9/D10 dienen ausschließlich als digitale Microstep-Signale.

Pulse/U = Vollschritte/U × Microstep-Teiler
Fahrtpulse = rund(Winkel × Pulse/U / 360)
Maximal-RPM durch Pulslimit = 4000 × 60 / Pulse/U

200 Vollschritte/U | Pulse/U | RPM-Obergrenze
1/8 | 1600 | 150
1/16 | 3200 | 75
1/32 · TB | 6400 | 37,5

Beispiel: 200 Vollschritte/U und 1/8 ergeben 1600 Pulse/U; 90° entsprechen 400 Pulsen. Gewünschte Drehzahlen oberhalb des Pulslimits werden begrenzt. Der Weg wird auf ganze Mikrostep-Impulse gerundet. Ohne Encoder können tatsächlicher Winkel, Schrittverluste, Spiel und Bewegung bei abgeschaltetem Haltestrom nicht erkannt werden.

Normale Richtungswechsel bremsen zunächst auf null; danach warten DIR und Treiberfreigabe mindestens nominal 5 ms vor dem Anlauf. Endliche Fahrten verwenden eine abgetastete Beschleunigungs-/Bremsrampe und werden im Timer exakt nach der vorgegebenen Impulszahl beendet. Dies ist keine Garantie, dass ein überlasteter Motor allen Pulsen folgt.

## 8. Fehler und Diagnose

Anzeige / Problem | Bedeutung und Vorgehen
FEHLER LCD/I2C · Code 1 | Display wurde nicht initialisiert oder ein I²C-Zugriff schlug fehl. SDA/SCL, 5V, Masse, Backpack und Lötstellen prüfen; danach Reset.
FEHLER Joystick · Code 2 | Startkalibrierung unplausibel: Mittelwerte außerhalb 350…674 oder Streuung über 40 ADC-Schritte. Stick freigeben, Belegung prüfen, Reset.
FEHLER Boardpins · Code 4 | Der gewählte Core-/Varianten-Pinplan passt nicht zu den erwarteten Portleitungen. Boardvariante prüfen; keine Motorfahrt freigeben.
FEHLER Speicher · Code 5 | EEPROM-Kapazität oder Zurücklesen der gespeicherten Daten ist fehlerhaft. E2PROM des LGT-Cores verwenden und Versorgung prüfen; danach Reset.
FEHLER Loop-Zeit · Code 3 | Der Hauptablauf hat den Timer länger als etwa 100 ms nicht bedient. Pulsfreigabe bleibt gesperrt; Ursache beseitigen, Reset.
LCD hell, keine lesbaren Zeichen | Backpack-Kontrast mit dem vorhandenen Potentiometer einstellen. Bei LCD/I²C-Fehler bleiben Fahrten gesperrt.
ARM, aber keine Bewegung | Taster loslassen, X und Y auslenken; richtigen Treiber und Motorversorgung prüfen. Nach Fahrtende X erneut zentrieren.
Drehrichtung vertauscht | Menüpunkt Richtung für das betroffene Profil ändern. Nur bei vertauschter Stickachse X_RIGHT_IS_HIGH ändern.
Menü Y läuft verkehrt | Y_UP_IS_LOW in Config.h umschalten. Beide Y-Richtungen bleiben im Fahrbetrieb Geschwindigkeitsbeträge.
TB hält trotz LOCK | Bei offenen ENA-Klemmen erwartetes Verhalten. LOCK verhindert Pulse und trennt keine Versorgung.
Fahrtwinkel stimmt nicht | Vollschritte, tatsächliches DIP-/MS-Microstepping, mögliche Untersetzung, Schrittverluste und Haltestrom prüfen.
Upload fehlgeschlagen | LGT8F328, richtige Variante und tatsächlichen Port wählen; seriellen Monitor schließen, Daten-USB-Kabel prüfen. Upload wurde hier nicht an realer Hardware getestet.

Serieller Monitor: 115200 Baud. ? gibt Firmwareversion, kompiliertes Chipziel, CPU-Takt, Treiber, Sperrzustand, Fehlercode, rohe ADC-Werte, kalibrierte Mitte, Pulsrate und Restpulse aus. s stoppt und sperrt. Es gibt keinen seriellen Startbefehl.

Die Timer-Lease unterbindet bei einem blockierten Hauptablauf neue Pulse und deaktiviert A4988 sowie optional TB-ENA. Sie ist softwarebasiert und funktioniert nur bei weiterlaufendem Timer-Interrupt. Sie ersetzt keine Stromtrennung. Joystick-Kabelbruch und mechanisches Nachlaufen werden nicht zuverlässig erkannt.

## 9. Reproduzierbarer LGT-Build

Für normale Nutzung genügt die Arduino IDE. Die folgende CLI-Installation verwendet den geprüften Core. Die Arduino-AVR-Plattform liefert gegebenenfalls die AVR-Toolchain; das eigentliche Buildziel bleibt lgt8fx.

arduino-cli core update-index --additional-urls https://raw.githubusercontent.com/dbuezas/lgt8fx/master/package_lgt8fx_index.json
arduino-cli core install arduino:avr@1.8.6
arduino-cli core install lgt8fx:avr@2.0.7 --additional-urls https://raw.githubusercontent.com/dbuezas/lgt8fx/master/package_lgt8fx_index.json
arduino-cli lib install "hd44780@1.3.2"
python tools/build.py --profile p16

Das Profil p16 ist die Bauvorgabe für P/LQFP32 bei 16 MHz, keine automatische Erkennung deiner Hardware. Bei abweichender Chipausführung entsprechend d16, d32, p32, p48_16 oder p48_32 wählen. Die vollständigen FQBNs stehen in board_profiles.json. HEX/ELF liegen getrennt in firmware/PROFIL; es gibt keine universelle Binärdatei für alle Takte.

python tools/make_single_file.py
python tools/build.py --profile p16 --single-file
python tools/run_tests.py
python tools/make_docs.py

Für einen manuellen CLI-Upload die passende FQBN und genau die zugehörige HEX-Datei verwenden. COM5 ist nur ein Beispiel:

arduino-cli upload --fqbn lgt8fx:avr:328:variant=modelP,clock_source=internal,clock_div=2,upload_speed=57600 -p COM5 --input-file firmware/p16/Stepper_Testbench_LGT8F328.hex

Die HEX-Dateien enthalten die Anwendung ohne Bootloader. Für den normalen IDE-Upload müssen sie nicht separat geöffnet werden. Die nativen Verhaltenstests benötigen g++ mit AddressSanitizer/UndefinedBehaviorSanitizer, etwa unter Linux/WSL. Im verwendeten Container war nur LeakSanitizer wegen /proc-Einschränkungen ausgeschaltet.

## 10. Prüfstatus

Ausgabe | Flash | Statischer RAM | Ergebnis
p16 | 22494 / 29696 Byte | 1274 / 2048 Byte | Kompiliert
p16_single | 22576 / 29696 Byte | 1274 / 2048 Byte | Kompiliert
p32 | 22480 / 29696 Byte | 1274 / 2048 Byte | Kompiliert
p32_single | 22562 / 29696 Byte | 1274 / 2048 Byte | Kompiliert
d16 | 22200 / 29696 Byte | 1275 / 2048 Byte | Kompiliert
d32 | 22186 / 29696 Byte | 1275 / 2048 Byte | Kompiliert
p48_16 | 22524 / 29696 Byte | 1274 / 2048 Byte | Kompiliert
p48_32 | 22510 / 29696 Byte | 1274 / 2048 Byte | Kompiliert

Toolchain: Arduino CLI 1.5.1, lgt8fx-Paket 2.0.7, AVR-GCC 7.3.0-atmel3.6.1-arduino7 und hd44780 1.3.2. Alle sechs Board-/Taktprofile sowie zwei P-Ein-Datei-Ausgaben wurden kompiliert. Build-Logs liegen in validation. Statischer Speicherbedarf und verbleibender SRAM sind keine gemessene Stackreserve. Die D-Builds enthalten die dokumentierte Warnung des Core-Herstellers zur nicht physisch getesteten D-EEPROM-Emulation.

- Die Timer-Vergleichswerte für 16/32 MHz und alle ganzzahligen Raten 1…4000 PPS über jeweils 10.000 Scheduler-Takte: Pulszahl und Mindestabstand geprüft.
- Endliche Blöcke, laufenden HIGH-Impuls beenden, letzte Flanke, kein Wiederanlauf nach Fahrtende, Timer-Lease.
- Tasterentprellung, Doppelklick, kontinuierlich zentrierte Freigabe, Loslasssperre, millis()-Überlauf.
- Richtungswechsel erst bei Stillstand, Freigabe-/DIR-Wartezeiten, getrennte Treiberausgänge, Menü, Halten und Fehlersperren.
- Alle Fahrtwinkel-Presets, kleinste Fahrt mit 2 und größte Fahrt mit 51.200 Impulsen, CRC/EEPROM-Migration und 16-Zeichen-Anzeigepuffer.

Offen: Kein realer Upload, elektrischer Versuch, Oszilloskop-Timing, Motorlastversuch oder thermischer Dauertest. Die nativen Tests verwenden denselben C++-Kern, aber einen modellierten Hardwareadapter. Sie simulieren weder die vollständige AVR-Interruptpriorität noch tatsächliche Optokoppler, LCD-Verkabelung oder Motorbewegung.

## 11. Ersttest zum Abhaken

- Pinbelegung und Modulorientierung bei ausgeschalteten Versorgungen geprüft.
- A4988-VMOT-Kondensator, Polarität und Stromlimit kontrolliert.
- TB-DIP-Strom und Microstep-Teiler kontrolliert; ENA im Standard offen.
- USB-Upload funktioniert; Display zeigt LOCK; ADC-Mitten im seriellen Status plausibel.
- Kurzer Tastendruck sperrt; Doppelklick öffnet Menü; Speichern führt zu LOCK.
- Beide Profile stimmen mit den tatsächlich angeschlossenen Motoren überein.
- Ersttest 5 RPM / 15° ohne Last; Richtung und Winkel geprüft.
- Joystickzentrierung im Dauerlauf bremst; kurzer Tastendruck stoppt auch eine Fahrt.
- Keine wiederholte Fahrt ohne X-Mittelstellung nach Fahrtende.
- Bei langsamem, lastfreiem Versuch mit Steuerspannung einen LCD-Verbindungsfehler prüfen: Pulse müssen nach erkanntem Fehler gesperrt bleiben. Leistungsteil dabei nicht umverdrahten.
- Erst danach Drehzahl, Beschleunigung, Strom und Versuchsdauer schrittweise erhöhen.

## 12. Quellen und Projektdateien

Die Paketquellen wurden auf die genannten Versionen festgelegt. Die LGT-Portierung wurde zusätzlich mit den LogicGreen-Datenbüchern P 1.0.5 und D 1.0.5 abgeglichen; Registerdetails stehen in lgt_port_notes.md. hd44780 und lgt8fx liegen als unveränderte Quellarchive unter third_party; ihre Prüfsummen und Herkunft stehen in NOTICE.md. Der eigene Firmwarecode steht unter GPL-3.0, Fremdcode behält seine enthaltenen Hinweise.

- hd44780 von Bill Perry (https://github.com/duinoWitchery/hd44780/tree/1.3.2) – Backpack-Erkennung und LCD-API.
- lgt8fx 2.0.7 (https://github.com/dbuezas/lgt8fx/tree/v2.0.7) – Boardprofile, ADC, Wire und E2PROM.
- Arduino CLI (https://docs.arduino.cc/arduino-cli/commands-reference/arduino-cli_compile) – Build und Boardauswahl.
- Pololu A4988 Carrier (https://www.pololu.com/product/1182) und Allegro A4988 (https://www.pololu.com/file/0J450/a4988_DMOS_microstepping_driver_with_translator.pdf) – Referenzanschluss, Microstep-Tabelle und Stromlimit.
- Handson TB6600-Modul (https://www.handsontec.com/dataspecs/module/TB6600-Motor-Driver.pdf) – Beispiel für ein 5-V-Optokopplermodul; kein universelles Klon-Datenblatt.

Die Anleitung funktioniert vollständig offline. Die Links dienen der Quellenangabe; keine externen Schriftarten, Bilder, Skripte oder Styles werden nachgeladen.

Stepper Testbench · Software 2.1.0 · Digitale Prüfung abgeschlossen; reale Hardware-Inbetriebnahme steht aus.
