Sandgrube/StepperMotorTestBench/PREVIEWS/assembled.png

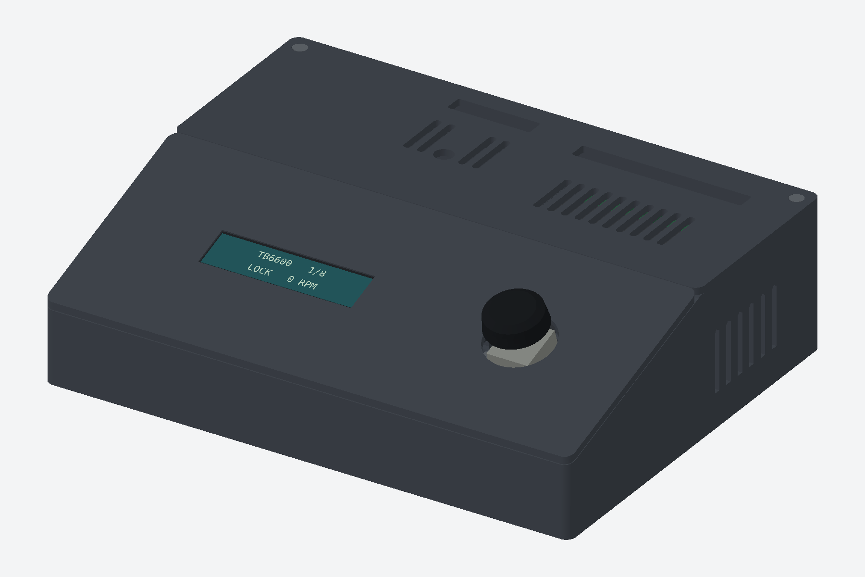
PREVIEWS/assembled.png
